electgpl/LogicAnalyzer2350/hard/LA8_Schematic.pdf

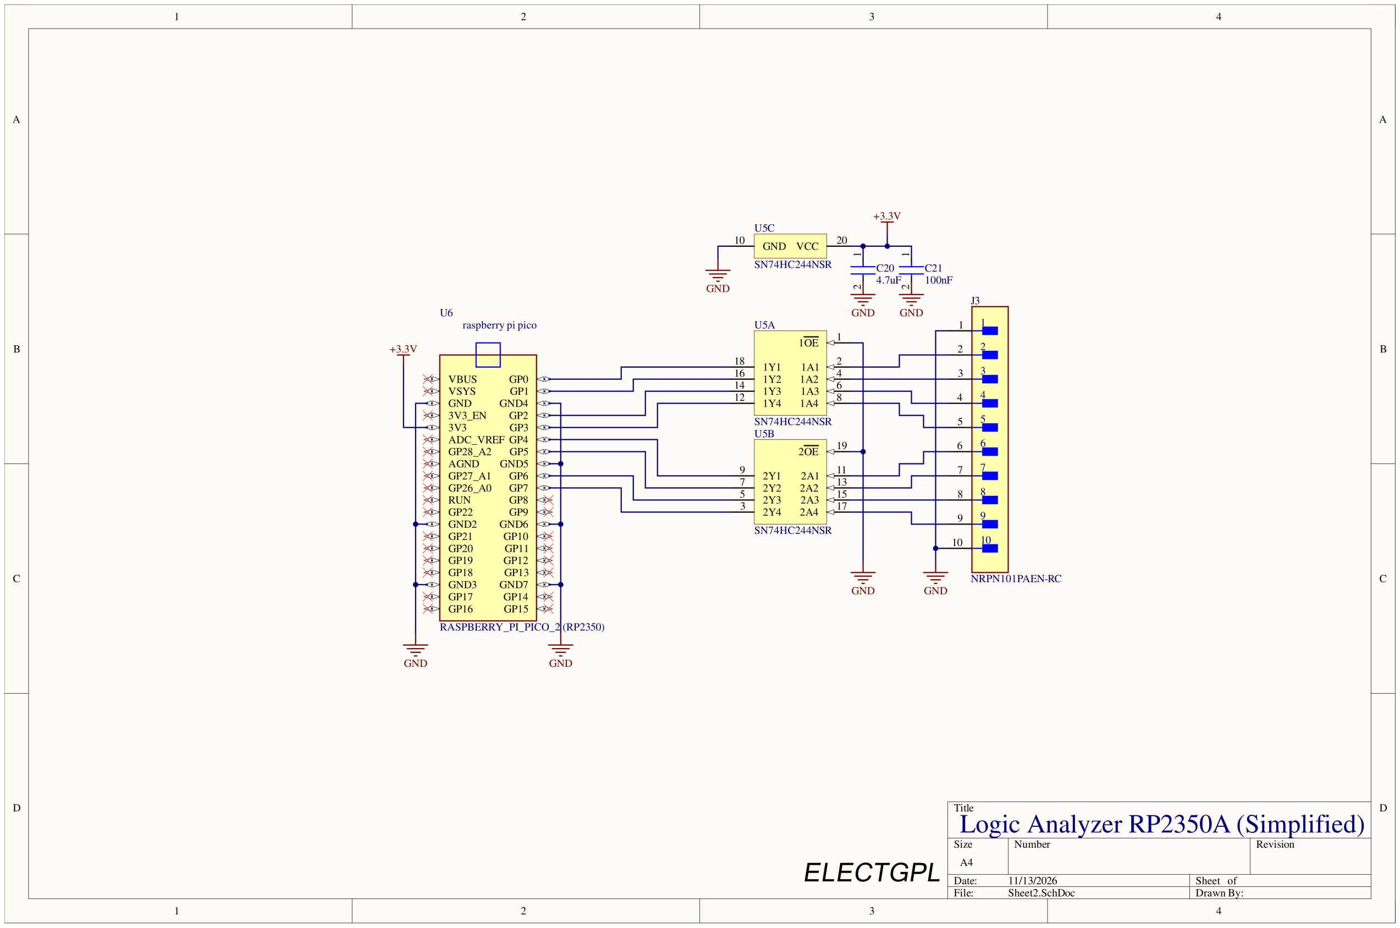
[picture p3: page 1]
