electgpl/LogicAnalyzer2350/hard/LA8_Schematic.png

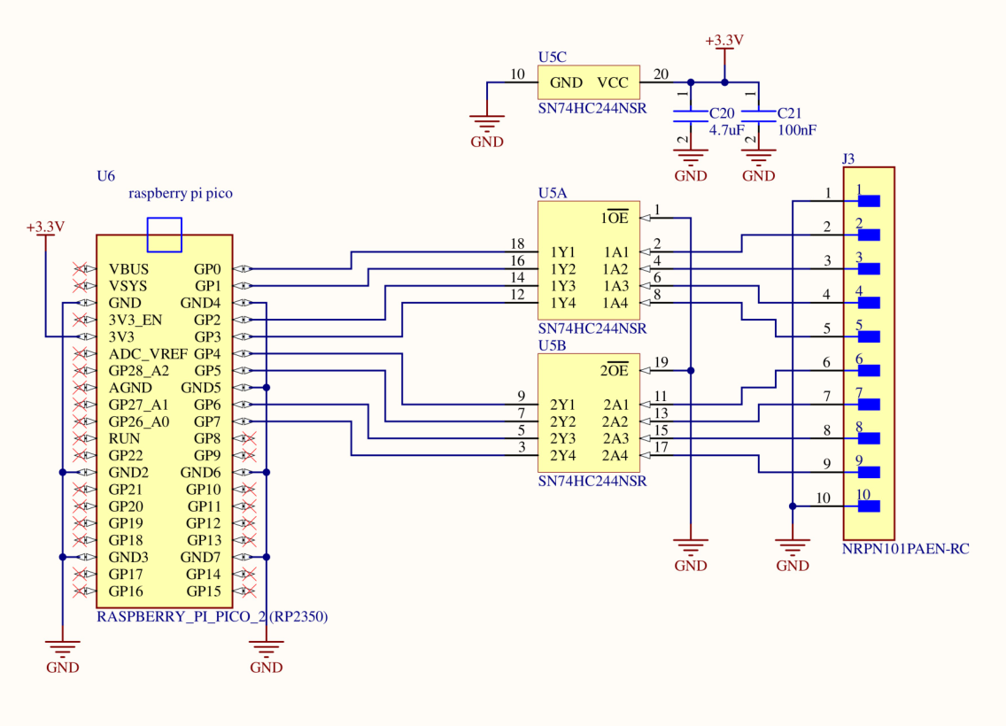
hard/LA8_Schematic.png
